JayDHulster/ithappens/arduinoNano.png

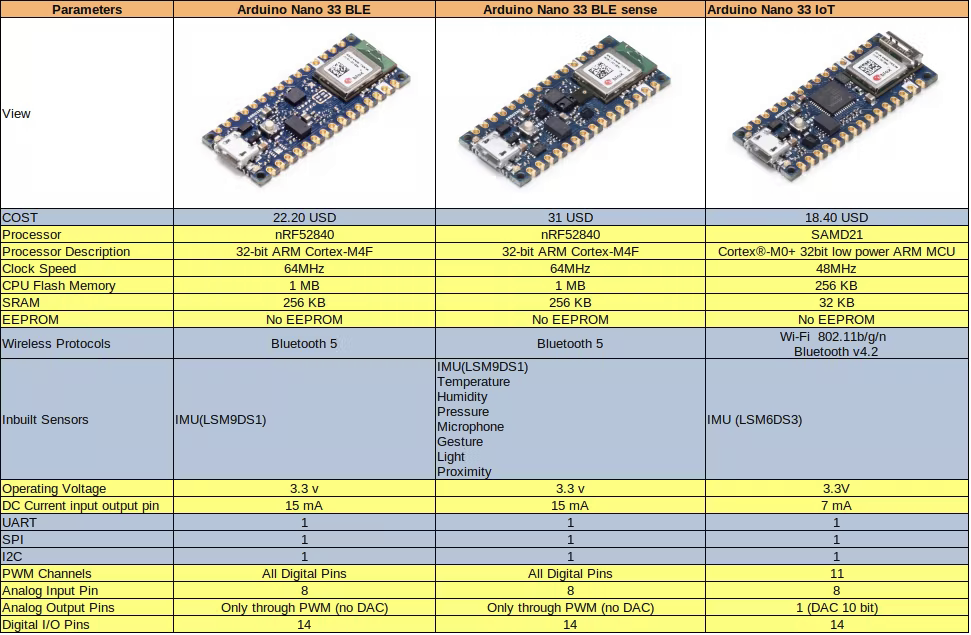
arduinoNano.png
