JayDHulster/ithappens/README.md

it happens

Te bekijken:

* https://github.com/smart-sensor-devices-ab/get_realtime_data_bleuio
* https://chipwired.com/collect-data-with-raspberry-pi/
