JayDHulster/ithappens/pcb/documentatie-biosensor.pdf

Bio-sensor: prototype

Datasheet 1/4inch druksensor

Dit is hoe het prototype
van de sensor werd
meegegeven

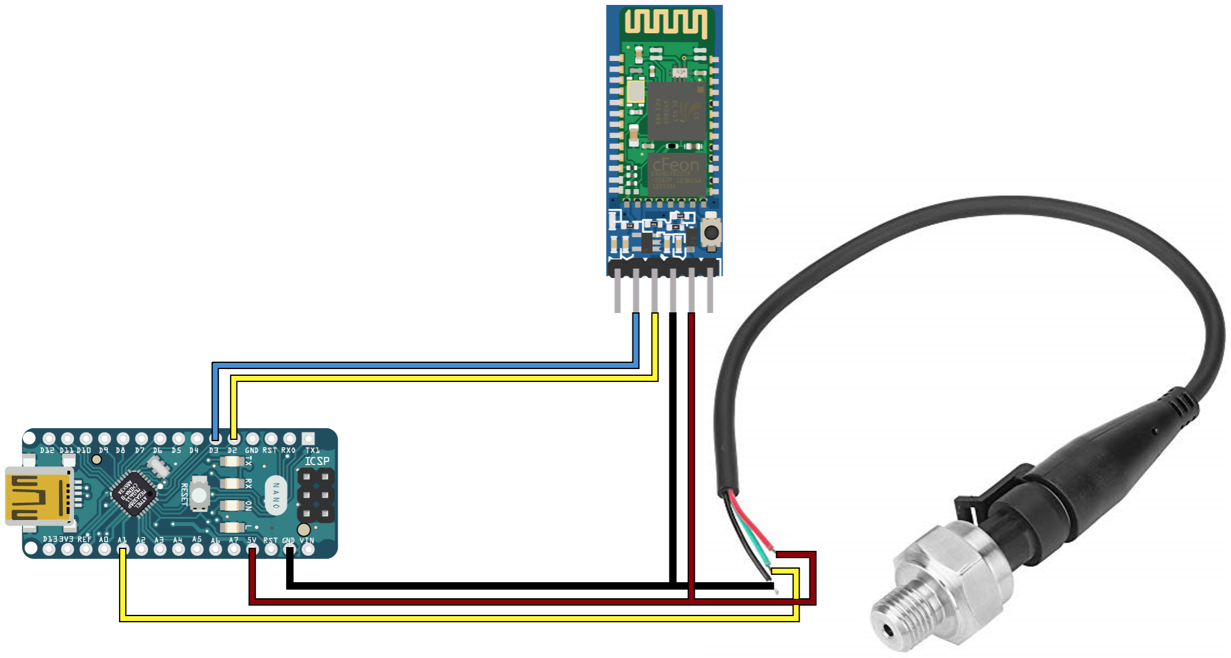
[picture p2: figure]

Verbeteringen:
Sensor testen en als de lezingen niet goed genoeg zijn een andere zoeken.

Als de sensor goed is, ontwerpen we de PCB om het systeem zo compact mogelijk te maken. Dit kunnen we doen met het KiCad programma of Eagle.
We kunnen inmiddels ook kijken voor een behuizing, zodat de elektronica beschermd wordt.

Componenten:
Arduino Nano BLE, Druksensor, Terminal Block Connector voor sensor, Batterijhouder, Batterij

Programmatie met de sensor

Betere code met calibratie:

De eerste verandering dat we kunnen doen is om de HC-05 bluetooth module eraf te smijten, inmiddels bestaat er nu een Arduino Nano 33 BLE (Bluetooth Low Energy) of de Nano 33 IoT microcontrollers met bluetooth ingebouwd.

Vervolgens kunnen we een pinout voorzien om de sensor op een gemakkelijke plaats aan te sluiten.

We zullen ook een batterij moeten voorzien om het systeem volledig draadloos te maken.

Als we op het bord zelf AI willen gebruiken (we moeten enkel maar data via bluetooth doorsturen), dan kunnen we de Arduino Nano 33 BLE Sense gebruiken met Embedded Artificial Intelligence; dit kost wel 35€


Bij gebruik van AI | [nice-to-have, niet noodzakelijk]:

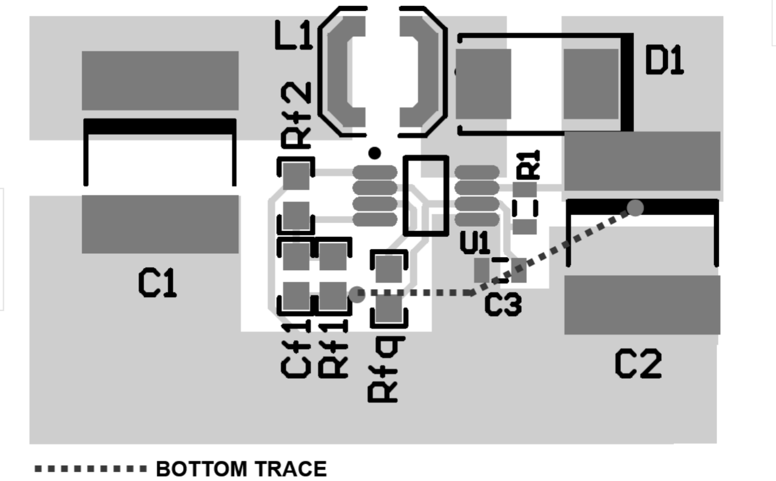
[picture p3: figure]

In deze discussie wordt uitgelegd hoe je het bordje zo lang mogelijk laat draaien op een batterij.
We kunnen ook de onboard regulator overslaan en rechtstreeks 3V3 aansluiten op de Nano, dit omdat de regulator ook energie verbruikt.

Dit artikel vermeldt ook dat deze configuratie wordt aangeraden in projecten waarbij de board voor lange tijden inactief is. Dit bord zal regelmatig data verzenden.

https://www.hackster.io/electronicsworkshop1 to-make-lipo-battery-charger-circuit-38f22f (https://www.hackster.io/electronicsworkshop111/how-to-make-lipo-battery-charger-circuit-38f22f)

www.hackster.io

https://www.instructables.com/Small-Format-Arduino-Nano-With-USB-Charging… (https://www.instructables.com/Small-Format-Arduino-Nano-With-USB-Charging-Circui/)

www.instructables.com

https://github.com/alltheworld/tp4056

github.com

https://bikepixels.com/2019/11/10/how-toadd-a-lipo-battery-in-our-arduino-projects/ (https://bikepixels.com/2019/11/10/how-to-add-a-lipo-battery-in-our-arduino-projects/)

bikepixels.com

We willen gebruikmaken van een lithium-ion of polymer batterij om het heroplaadbaar te maken.

Batterijbescherming:

Boost converter:

Behuizing: WH170-33-N

https://www.ti.com/lit/ds/symlink/lm2621.pdfts=1677760204285&ref_url=https%253A%252 (https://www.ti.com/lit/ds/symlink/lm2621.pdf?ts=1677760204285)

www.ti.com

https://www.takachi-enclosure.com/products/WH (https://www.takachi-enclosure.com/products/WH)

www.takachi-enclosure.com

https://forum.arduino.cc/t/nano-33-bleexternal-power-supply/919311/3 (https://forum.arduino.cc/t/nano-33-ble-external-power-supply/919311/3)

forum.arduino.cc

https://www.analyticsvidhya.com/blog/2022/0python-libraries-for-time-series-analysis/ (https://www.analyticsvidhya.com/blog/2022/05/5-python-libraries-for-time-series-analysis/)

www.analyticsvidhya.com

https://media.digikey.com/pdf/Data%20Sheet

media.digikey.com

https://www.youtube.com/watch?v=UrqPxwsPWGk (https://www.youtube.com/watch?v=UrqPxwsPWGk)

www.youtube.com

https://forum.arduino.cc/t/pressuretransducer-code/362754/36 (https://forum.arduino.cc/t/pressure-transducer-code/362754/36)

forum.arduino.cc

https://support.arduino.cc/hc/enus/articles/360014735580-Nano-boards-… (https://support.arduino.cc/hc/en-us/articles/360014735580-Nano-boards-that-can-be-powered-directly-with-3-3-V)

support.arduino.cc

https://github.com/arduinolibraries/ArduinoBLE/pull/15#issuecomme… (https://github.com/arduino-libraries/ArduinoBLE/pull/15#issuecomment-530084737)

github.com

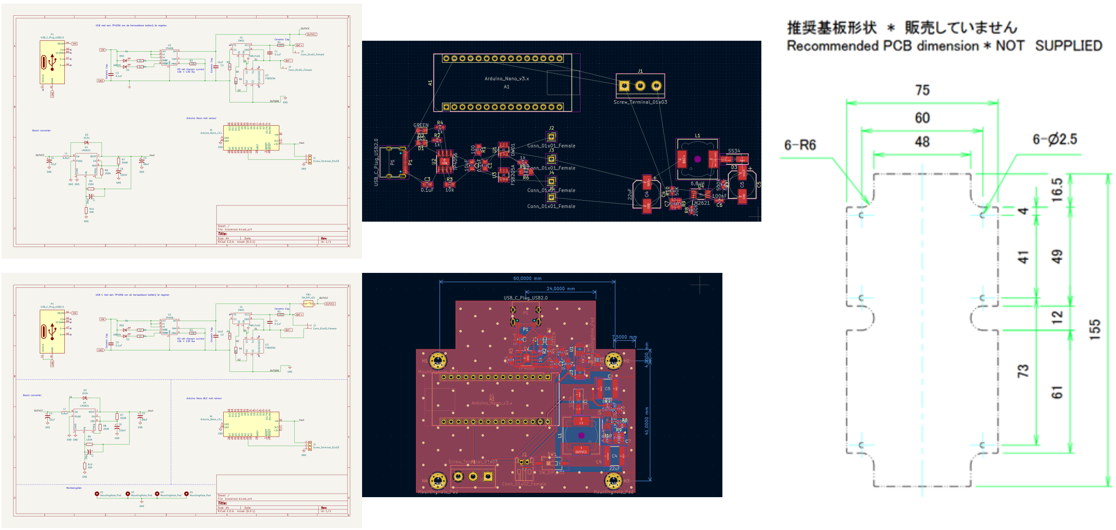
[picture p4: figure]
