JayDHulster/ithappens/app-design/concept.png

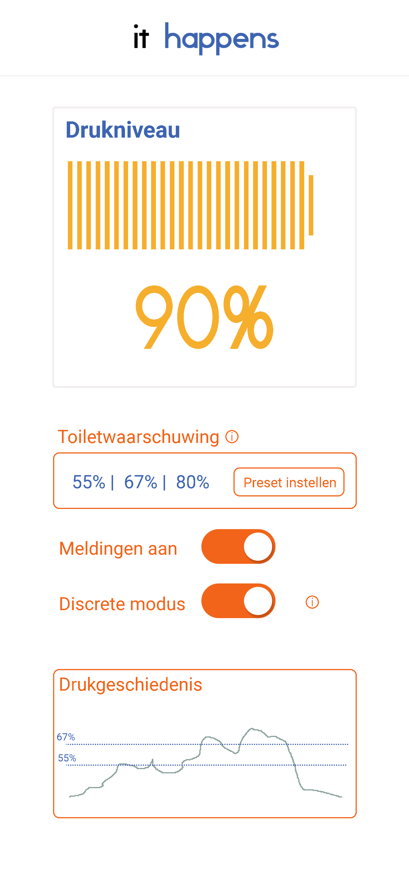
app-design/concept.png
