JayDHulster/ithappens/app-design/conceptv2.png

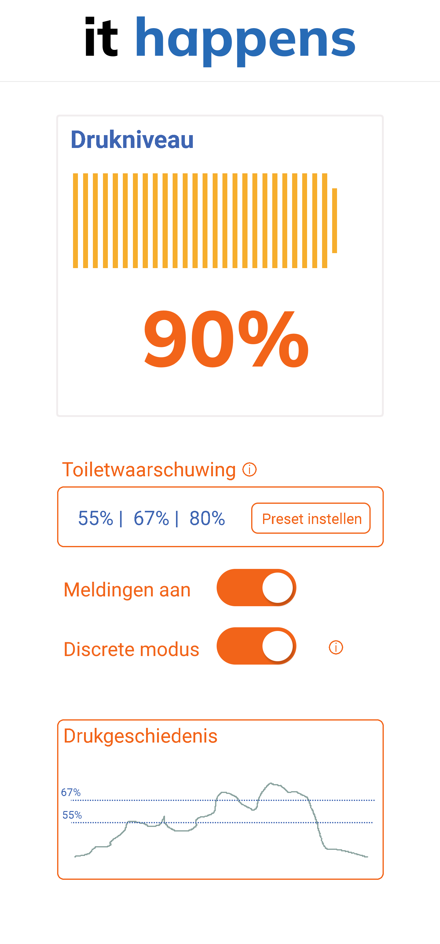
app-design/conceptv2.png
