JayDHulster/ithappens/app-design/drukpercentage.png

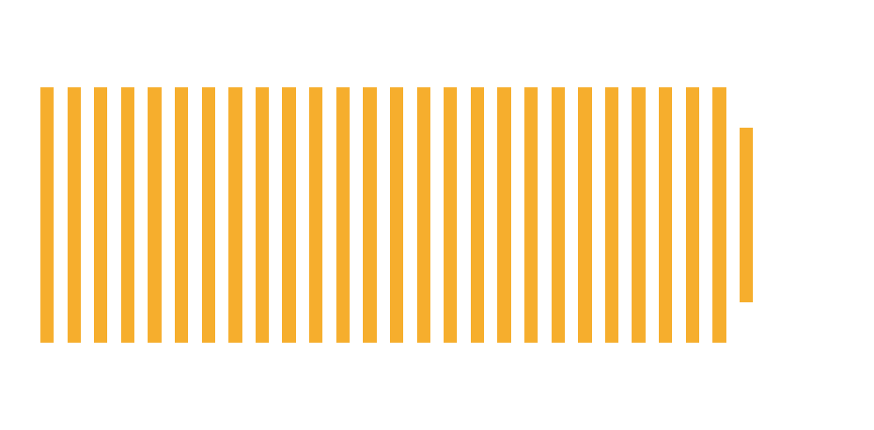
app-design/drukpercentage.png
