JayDHulster/ithappens/app-design/kleurenpalet.png

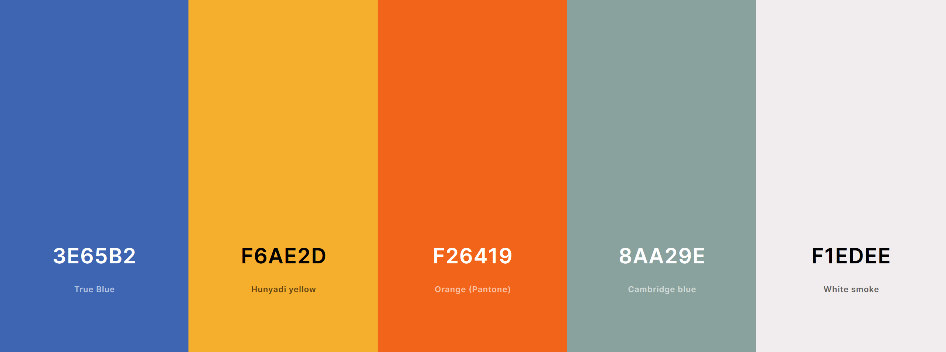
app-design/kleurenpalet.png
