JayDHulster/ithappens/schematics/first-prototype.png

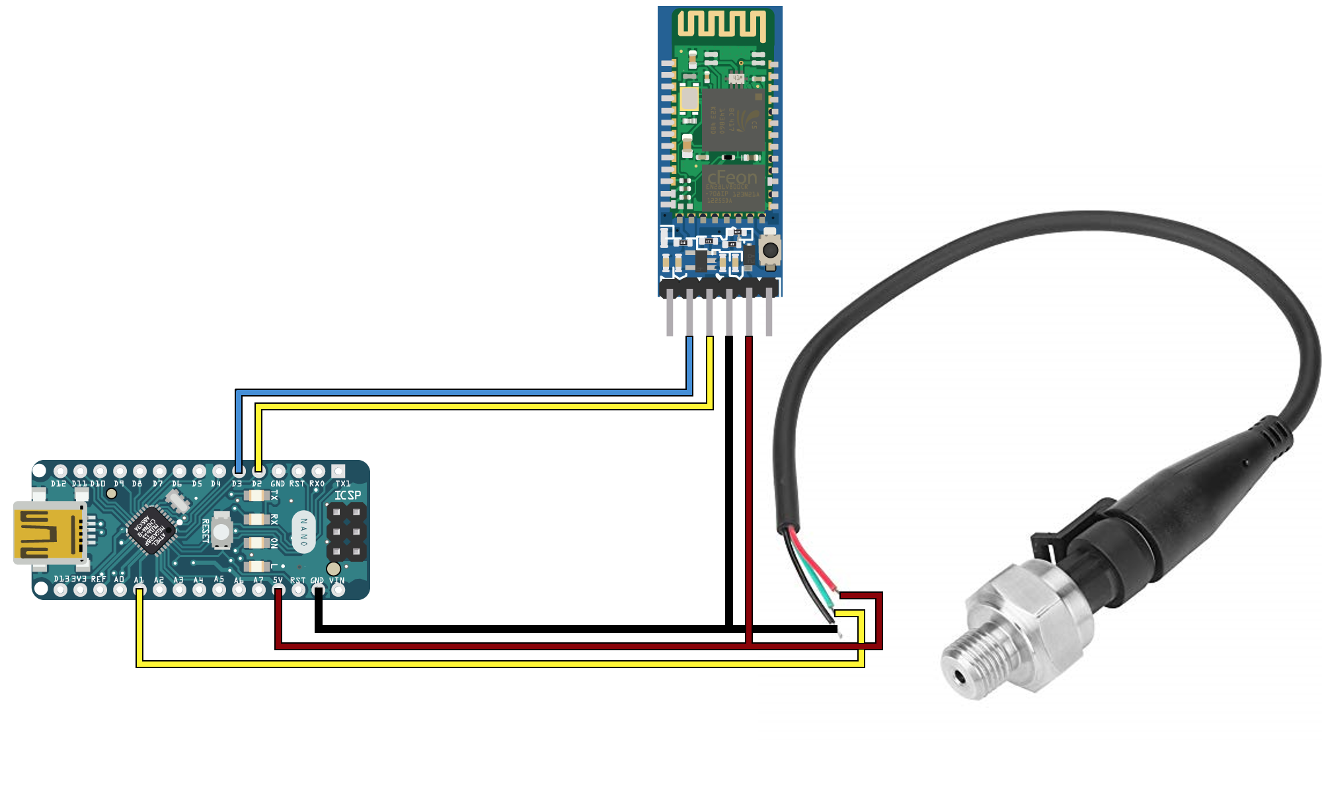
schematics/first-prototype.png
