JayDHulster/ithappens/pcb/595D/LPS4018-223MRC.stp

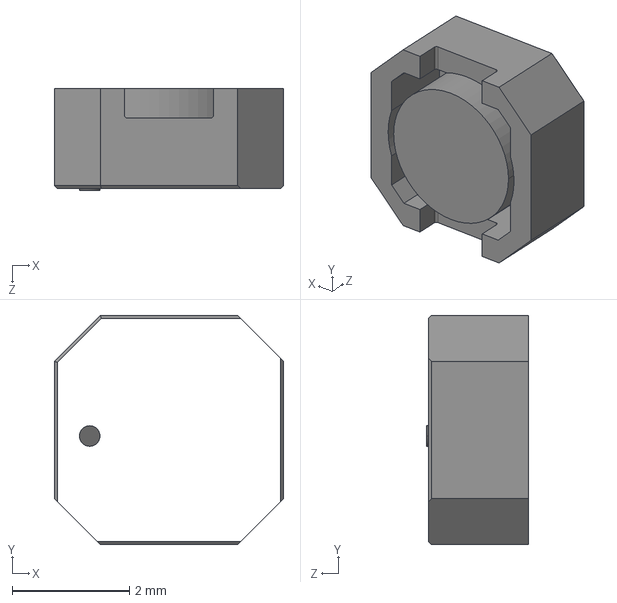
[picture p10: CAD file, 2023-06-10]
pcb/595D/LPS4018-223MRC.stp
3.90 x 3.90 x 1.73 mm
