JayDHulster/ithappens/pcb/biosensor/biosensor.kicad_pcb

## KiCad design pcb/biosensor/biosensor.kicad_pcb (2023-06-10)

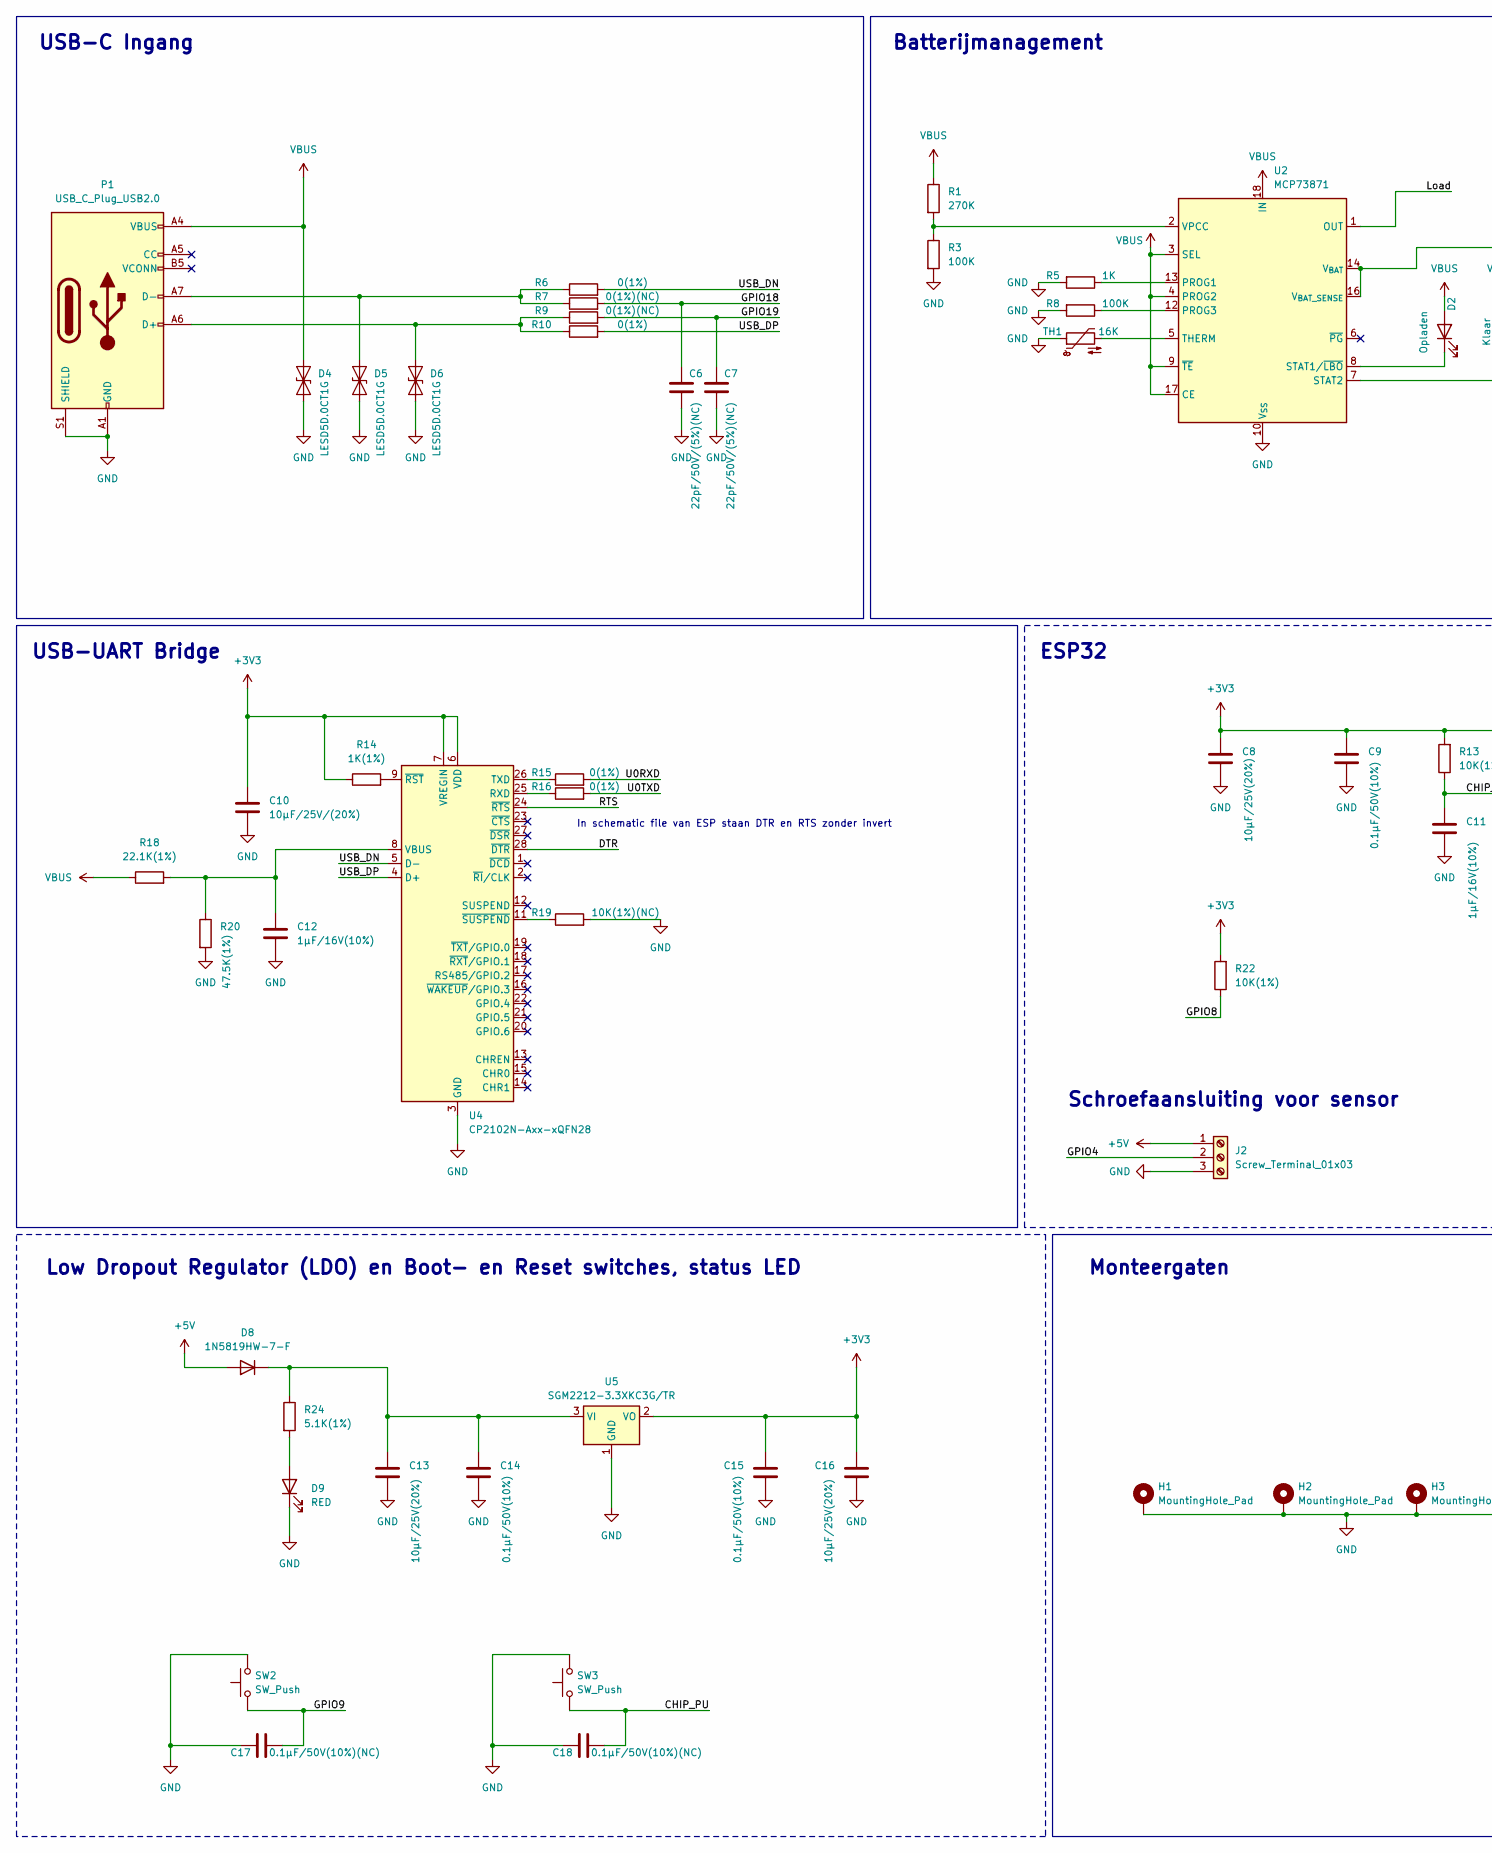
[picture p11: schematic biosensor.kicad_sch, part in row 1, column 1]

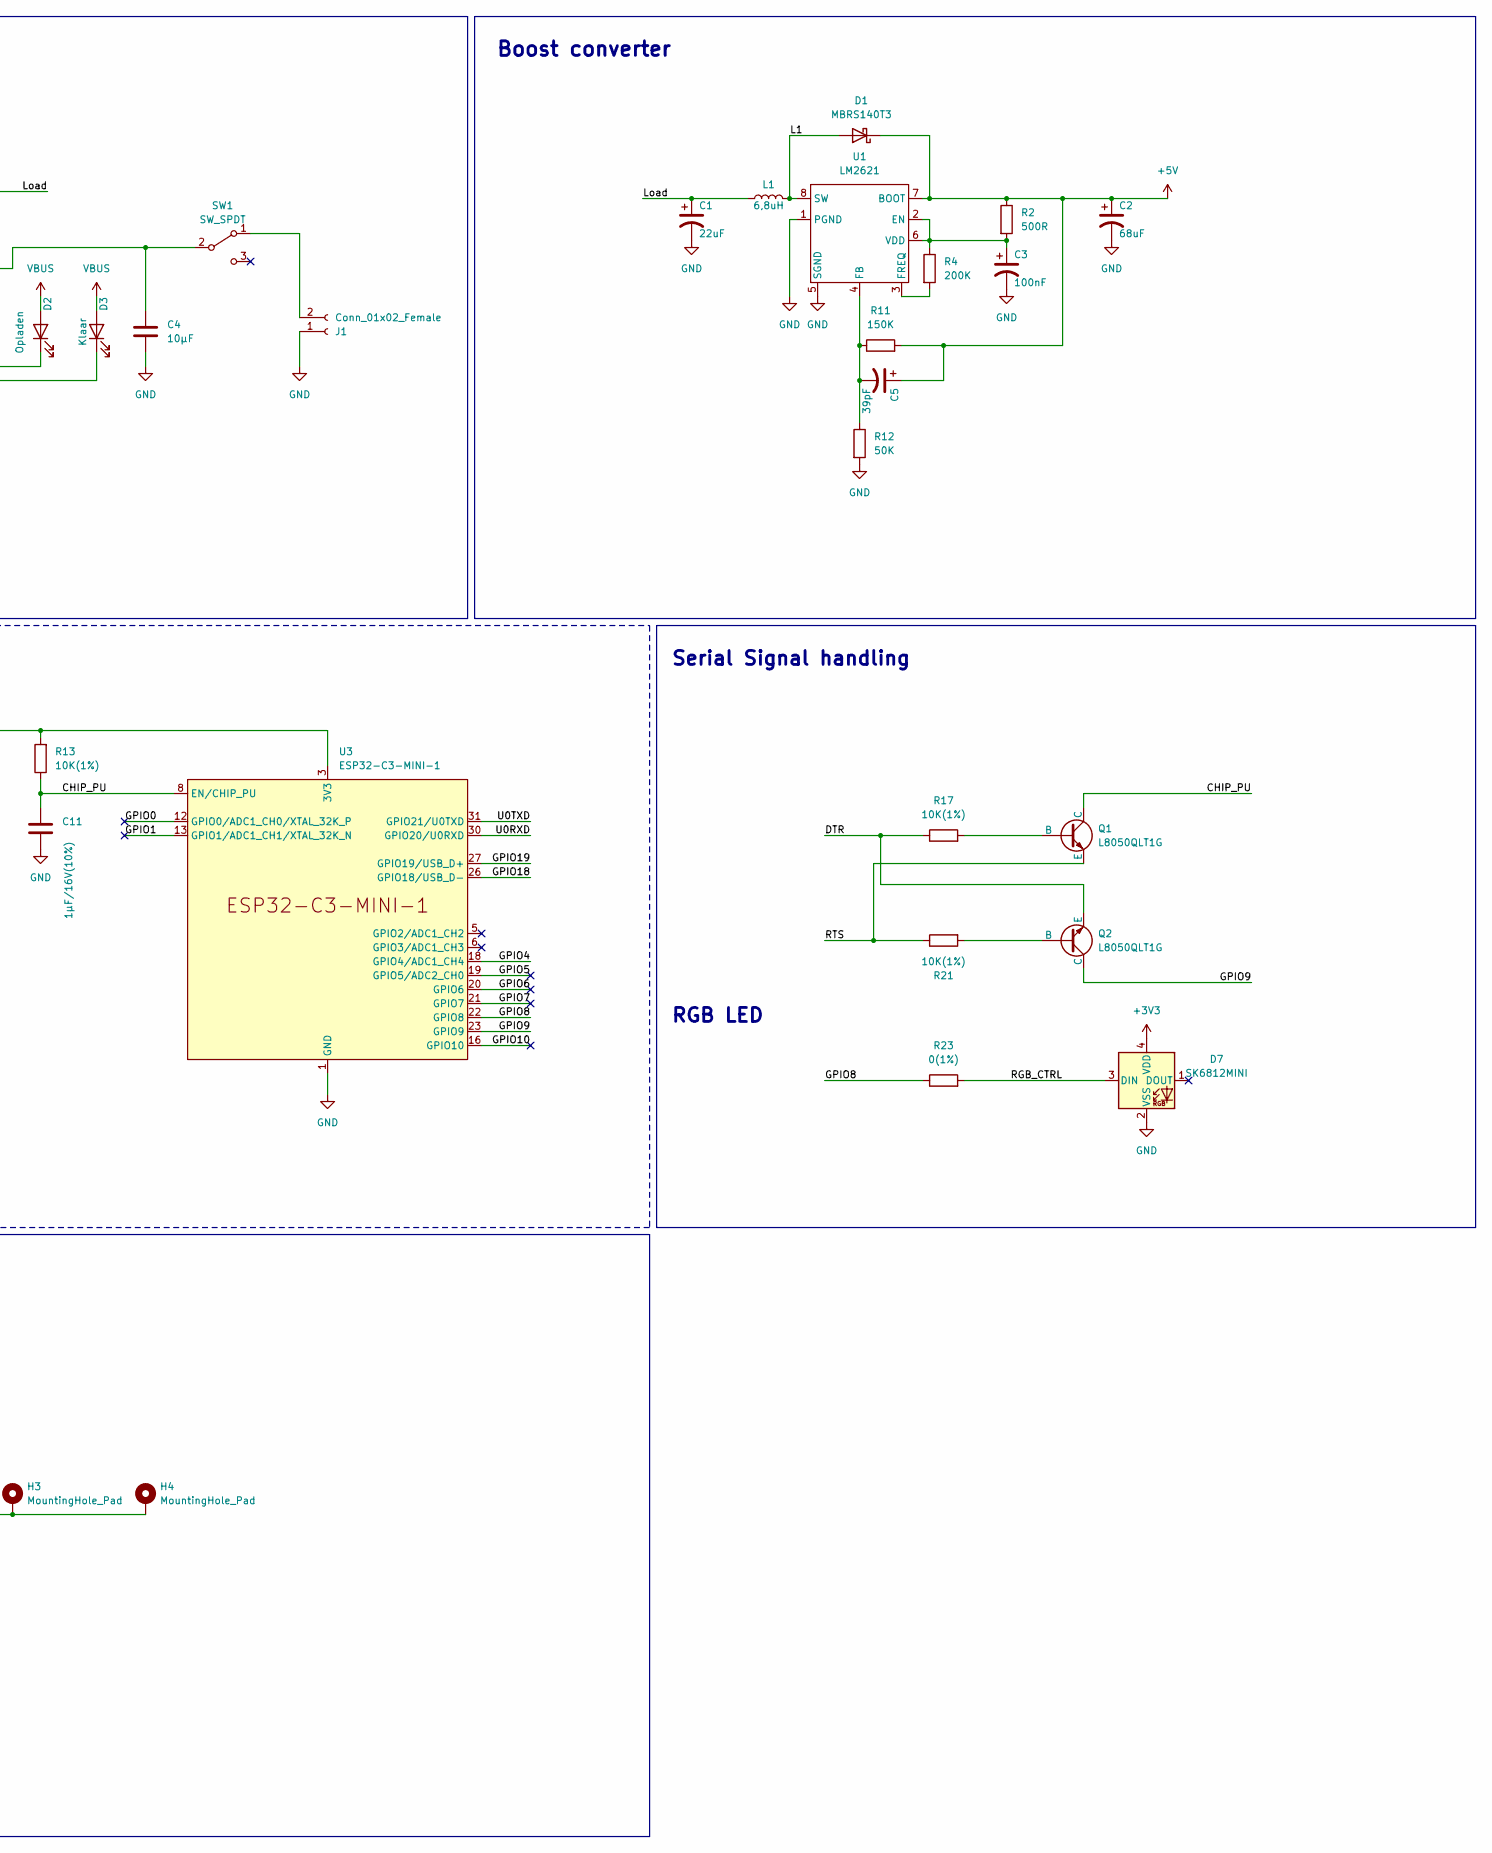
[picture p12: schematic biosensor.kicad_sch, part in row 1, column 2]

Parts:
C1: 22uF; CAP_595D-B_VSS
C2: 68uF; CAP_595D-C_VSS
C3: 100nF; C_0603_1608Metric_Pad1.08x0.95mm_HandSolder
C4: 10µF; C_0603_1608Metric_Pad1.08x0.95mm_HandSolder
C5: 39pF; C_0603_1608Metric_Pad1.08x0.95mm_HandSolder
C6, C7: 22pF/50V/(5%)(NC); C_0603_1608Metric_Pad1.08x0.95mm_HandSolder
C8, C13, C16: 10µF/25V(20%); C_0603_1608Metric_Pad1.08x0.95mm_HandSolder
C9, C14, C15: 0.1µF/50V(10%); C_0603_1608Metric_Pad1.08x0.95mm_HandSolder
C10: 10µF/25V/(20%); C_0603_1608Metric_Pad1.08x0.95mm_HandSolder
C11, C12: 1µF/16V(10%); C_0603_1608Metric_Pad1.08x0.95mm_HandSolder
C17, C18: 0.1µF/50V(10%)(NC); C_0603_1608Metric_Pad1.08x0.95mm_HandSolder
D1: MBRS140T3; D_SMB_Handsoldering
D2: Opladen; LED_0805_2012Metric_Pad1.15x1.40mm_HandSolder
D3: Klaar; LED_0805_2012Metric_Pad1.15x1.40mm_HandSolder
D4, D5, D6: LESD5D.0CT1G; D_SOD-523
D7: SK6812MINI; LED_SK6812MINI_PLCC4_3.5x3.5mm_P1.75mm
D8: 1N5819HW-7-F; D_SOD-123
D9: RED; LED_0805_2012Metric_Pad1.15x1.40mm_HandSolder
H1, H2, H3, H4: MountingHole_Pad; MountingHole_2.7mm_Pad_Via
J1: Conn_01x02_Female; JST_PH_S2B-PH-K_1x02_P2.00mm_Horizontal
J2: Screw_Terminal_01x03; TerminalBlock_bornier-3_P5.08mm
L1: 6,8uH; LPS4018223MRC
P1: USB_C_Plug_USB2.0; USB_C_Receptacle_HRO_TYPE-C-31-M-12
Q1, Q2: L8050QLT1G; SOT-23
R1: 270K; R_0603_1608Metric_Pad0.98x0.95mm_HandSolder
R2: 500R; R_0603_1608Metric
R3, R8: 100K; R_0603_1608Metric_Pad0.98x0.95mm_HandSolder
R4: 200K; R_0603_1608Metric
R5: 1K; R_0603_1608Metric_Pad0.98x0.95mm_HandSolder
R6, R10, R15, R16, R23: 0(1%); R_0603_1608Metric_Pad0.98x0.95mm_HandSolder
R7, R9: 0(1%)(NC); R_0603_1608Metric_Pad0.98x0.95mm_HandSolder
R11: 150K; R_0603_1608Metric_Pad0.98x0.95mm_HandSolder
R12: 50K; R_0603_1608Metric_Pad0.98x0.95mm_HandSolder
R13, R17, R21, R22: 10K(1%); R_0603_1608Metric_Pad0.98x0.95mm_HandSolder
R14: 1K(1%); R_0603_1608Metric_Pad0.98x0.95mm_HandSolder
R18: 22.1K(1%); R_0603_1608Metric_Pad0.98x0.95mm_HandSolder
R19: 10K(1%)(NC); R_0603_1608Metric_Pad0.98x0.95mm_HandSolder
R20: 47.5K(1%); R_0603_1608Metric_Pad0.98x0.95mm_HandSolder
R24: 5.1K(1%); R_0603_1608Metric_Pad0.98x0.95mm_HandSolder
SW1: SW_SPDT; SW_Slide_1P2T_CK_OS102011MS2Q
SW2, SW3: SW_Push; SW_PUSH_6mm
TH1: 16K; R_0603_1608Metric_Pad0.98x0.95mm_HandSolder
U1: LM2621; VSSOP-8_3.0x3.0mm_P0.65mm
U2: MCP73871; QFN-20-1EP_4x4mm_P0.5mm_EP2.5x2.5mm
U3: ESP32-C3-MINI-1
U4: CP2102N-Axx-xQFN28; QFN-28-1EP_5x5mm_P0.5mm_EP3.35x3.35mm
U5: SGM2212-3.3XKC3G/TR; SOT-223-3_TabPin2

Connections:
+3V3: C8.1, C9.1, C10.1, C15.1, C16.1, D7.4 (VDD), R13.2, R14.1, R22.2, U3.3 (3V3), U4.6 (VDD), U4.7 (VREGIN), U5.2 (VO)
+5V: C2.1, C5.1, D1.1 (K), D8.2 (A), J2.1, R2.1, R11.2, U1.7 (BOOT)
/CHIP_PU: C11.1, C18.2, Q1.1 (C), R13.1, SW3.1, U3.8 (EN/CHIP_PU)
/DTR: Q2.3 (E), R17.1, U4.28 (~DTR)
/GPIO0: U3.12 (GPIO0/ADC1_CH0/XTAL_32K_P)
/GPIO1: U3.13 (GPIO1/ADC1_CH1/XTAL_32K_N)
/GPIO4: J2.2, U3.18 (GPIO4/ADC1_CH4)
/GPIO5: U3.19 (GPIO5/ADC2_CH0)
/GPIO6: U3.20 (GPIO6)
/GPIO7: U3.21 (GPIO7)
/GPIO8: R22.1, R23.1, U3.22 (GPIO8)
/GPIO9: C17.2, Q2.1 (C), SW2.1, U3.23 (GPIO9)
/GPIO10: U3.16 (GPIO10)
/GPIO18: C6.1, R7.2, U3.26 (GPIO18/USB_D-)
/GPIO19: C7.1, R9.2, U3.27 (GPIO19/USB_D+)
/L1: D1.2 (A), L1.2, U1.8 (SW)
/Load: C1.1, L1.1, U2.1 (OUT), U2.20 (OUT)
/RGB_CTRL: D7.3 (DIN), R23.2
/RTS: Q1.3 (E), R21.1, U4.24 (~RTS)
/U0RXD: R15.2, U3.30 (GPIO20/U0RXD)
/U0TXD: R16.2, U3.31 (GPIO21/U0TXD)
/USB_DN: R6.2, U4.5 (D-)
/USB_DP: R10.2, U4.4 (D+)
GND: C1.2, C2.2, C3.2, C4.2, C6.2, C7.2, C8.2, C9.2, C10.2, C11.2, C12.2, C13.2, C14.2, C15.2, C16.2, C17.1, C18.1, D4.1 (A1), D5.1 (A1), D6.1 (A1), D7.2 (VSS), D9.1 (K), H1.1, H2.1, H3.1, H4.1, J1.1, J2.3, P1.A1 (GND), P1.A12 (GND), P1.B1 (GND), P1.B12 (GND), P1.S1 (SHIELD), R3.2, R5.2, R8.2, R12.2, R19.2, R20.2, SW2.2, SW3.2, TH1.1, U1.1 (PGND), U1.5 (SGND), U2.10 (V_{SS}), U2.11 (V_{SS}), U2.21 (V_{SS}), U3.1 (GND), U3.2 (GND), U3.11 (GND), U3.14 (GND), U3.36 (GND), U3.37 (GND), U3.38 (GND), U3.39 (GND), U3.40 (GND), U3.41 (GND), U3.42 (GND), U3.43 (GND), U3.44 (GND), U3.45 (GND), U3.46 (GND), U3.47 (GND), U3.48 (GND), U3.49 (GND), U3.50 (GND), U3.51 (GND), U3.52 (GND), U3.53 (GND), U4.3 (GND), U4.29 (GND), U5.1 (GND)
unnamed: D2.1 (K), U2.8 (STAT1/~LBO)
unnamed: D3.1 (K), U2.7 (STAT2)
unnamed: D5.2 (A2), P1.A7 (D-), R6.1, R7.1
unnamed: D6.2 (A2), P1.A6 (D+), R9.1, R10.1
unnamed: C13.1, C14.1, D8.1 (K), R24.1, U5.3 (VI)
unnamed: D9.2 (A), R24.2
unnamed: J1.2, SW1.1 (A)
unnamed: Q1.2 (B), R17.2
unnamed: Q2.2 (B), R21.2
unnamed: C4.1, SW1.2 (B), U2.14 (V_{BAT}), U2.15 (V_{BAT}), U2.16 (V_{BAT_SENSE})
unnamed: C3.1, R2.2, R4.1, U1.2 (EN), U1.6 (VDD)
unnamed: C5.2, R11.1, R12.1, U1.4 (FB)
unnamed: R4.2, U1.3 (FREQ)
unnamed: R5.1, U2.13 (PROG1)
unnamed: R8.1, U2.12 (PROG3)
unnamed: TH1.2, U2.5 (THERM)
unnamed: R1.2, R3.1, U2.2 (VPCC)
unnamed: R16.1, U4.25 (RXD)
unnamed: R15.1, U4.26 (TXD)
unnamed: C12.1, R18.2, R20.1, U4.8 (VBUS)
unnamed: R14.2, U4.9 (~RST)
unnamed: R19.1, U4.11 (~SUSPEND)
VBUS: D2.2 (A), D3.2 (A), D4.2 (A2), P1.A4 (VBUS), P1.A9 (VBUS), P1.B4 (VBUS), P1.B9 (VBUS), R1.1, R18.1, U2.3 (SEL), U2.4 (PROG2), U2.9 (~TE), U2.17 (CE), U2.18 (IN), U2.19 (IN)

Notes on the sheet:
Low Dropout Regulator (LDO) en Boot- en Reset switches, status LED
RGB LED
USB-C Ingang
In schematic file van ESP staan DTR en RTS zonder invert
Boost converter
Monteergaten
USB-UART Bridge
Batterijmanagement
Serial Signal handling
Schroefaansluiting voor sensor
ESP32

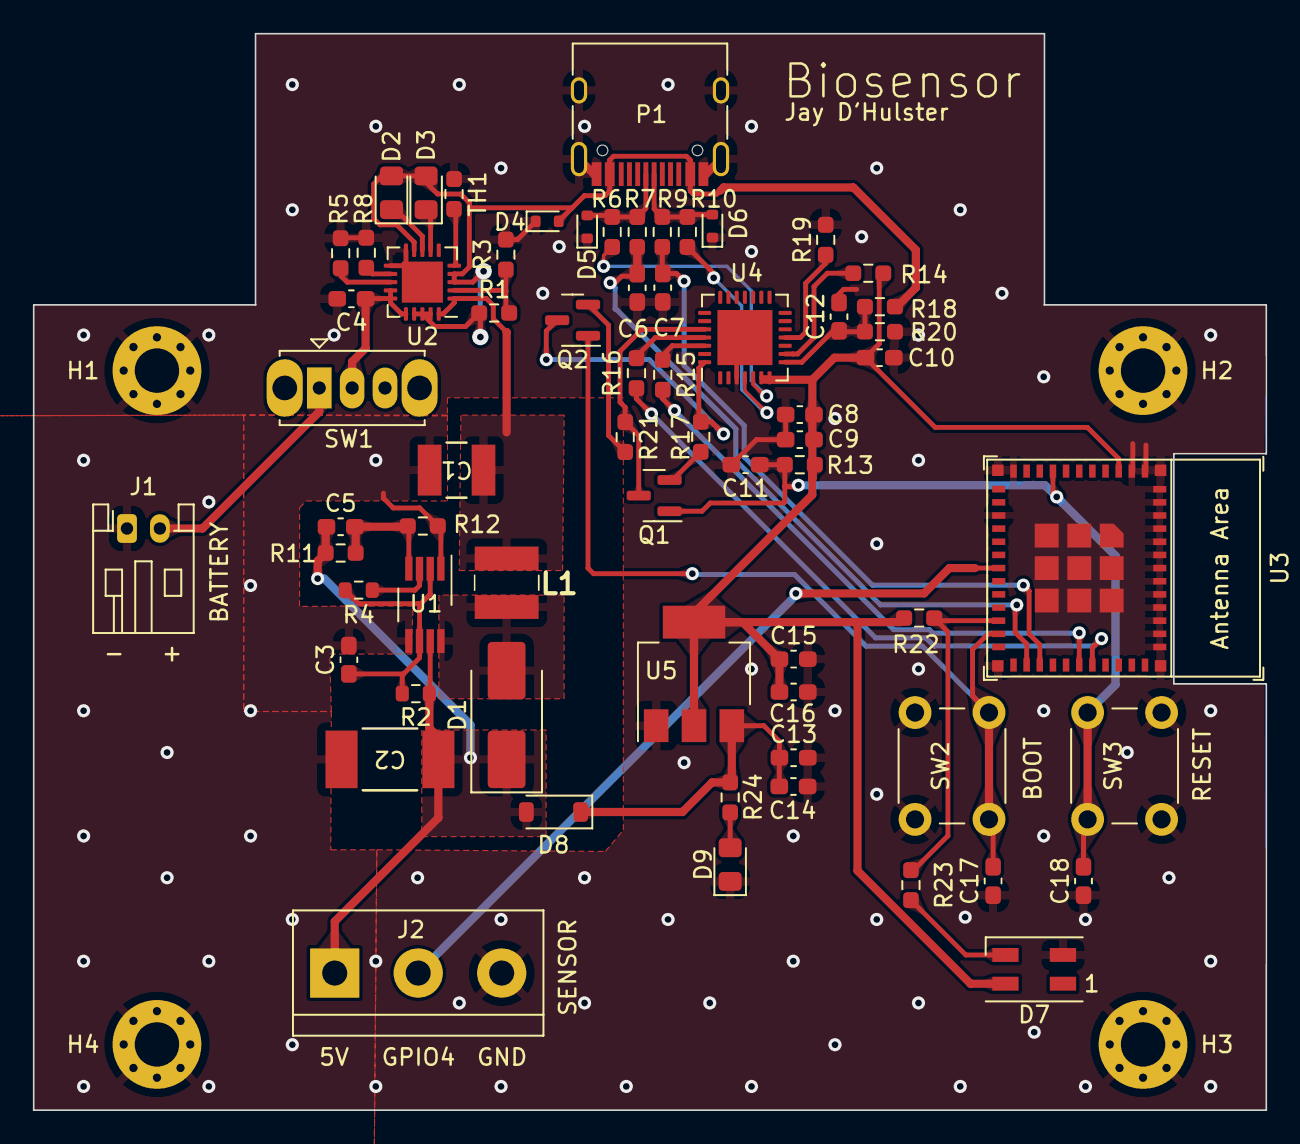
[picture p13: board pcb/biosensor/biosensor.kicad_pcb from above]

Board: 2 copper layers, 75.0 x 65.5 mm, 70 parts (0 on the bottom side), 41 nets.
