JayDHulster/ithappens/pcb/biosensor - v1/biosensor.kicad_pcb

## KiCad design pcb/biosensor - v1/biosensor.kicad_pcb (2023-03-20, an earlier design)

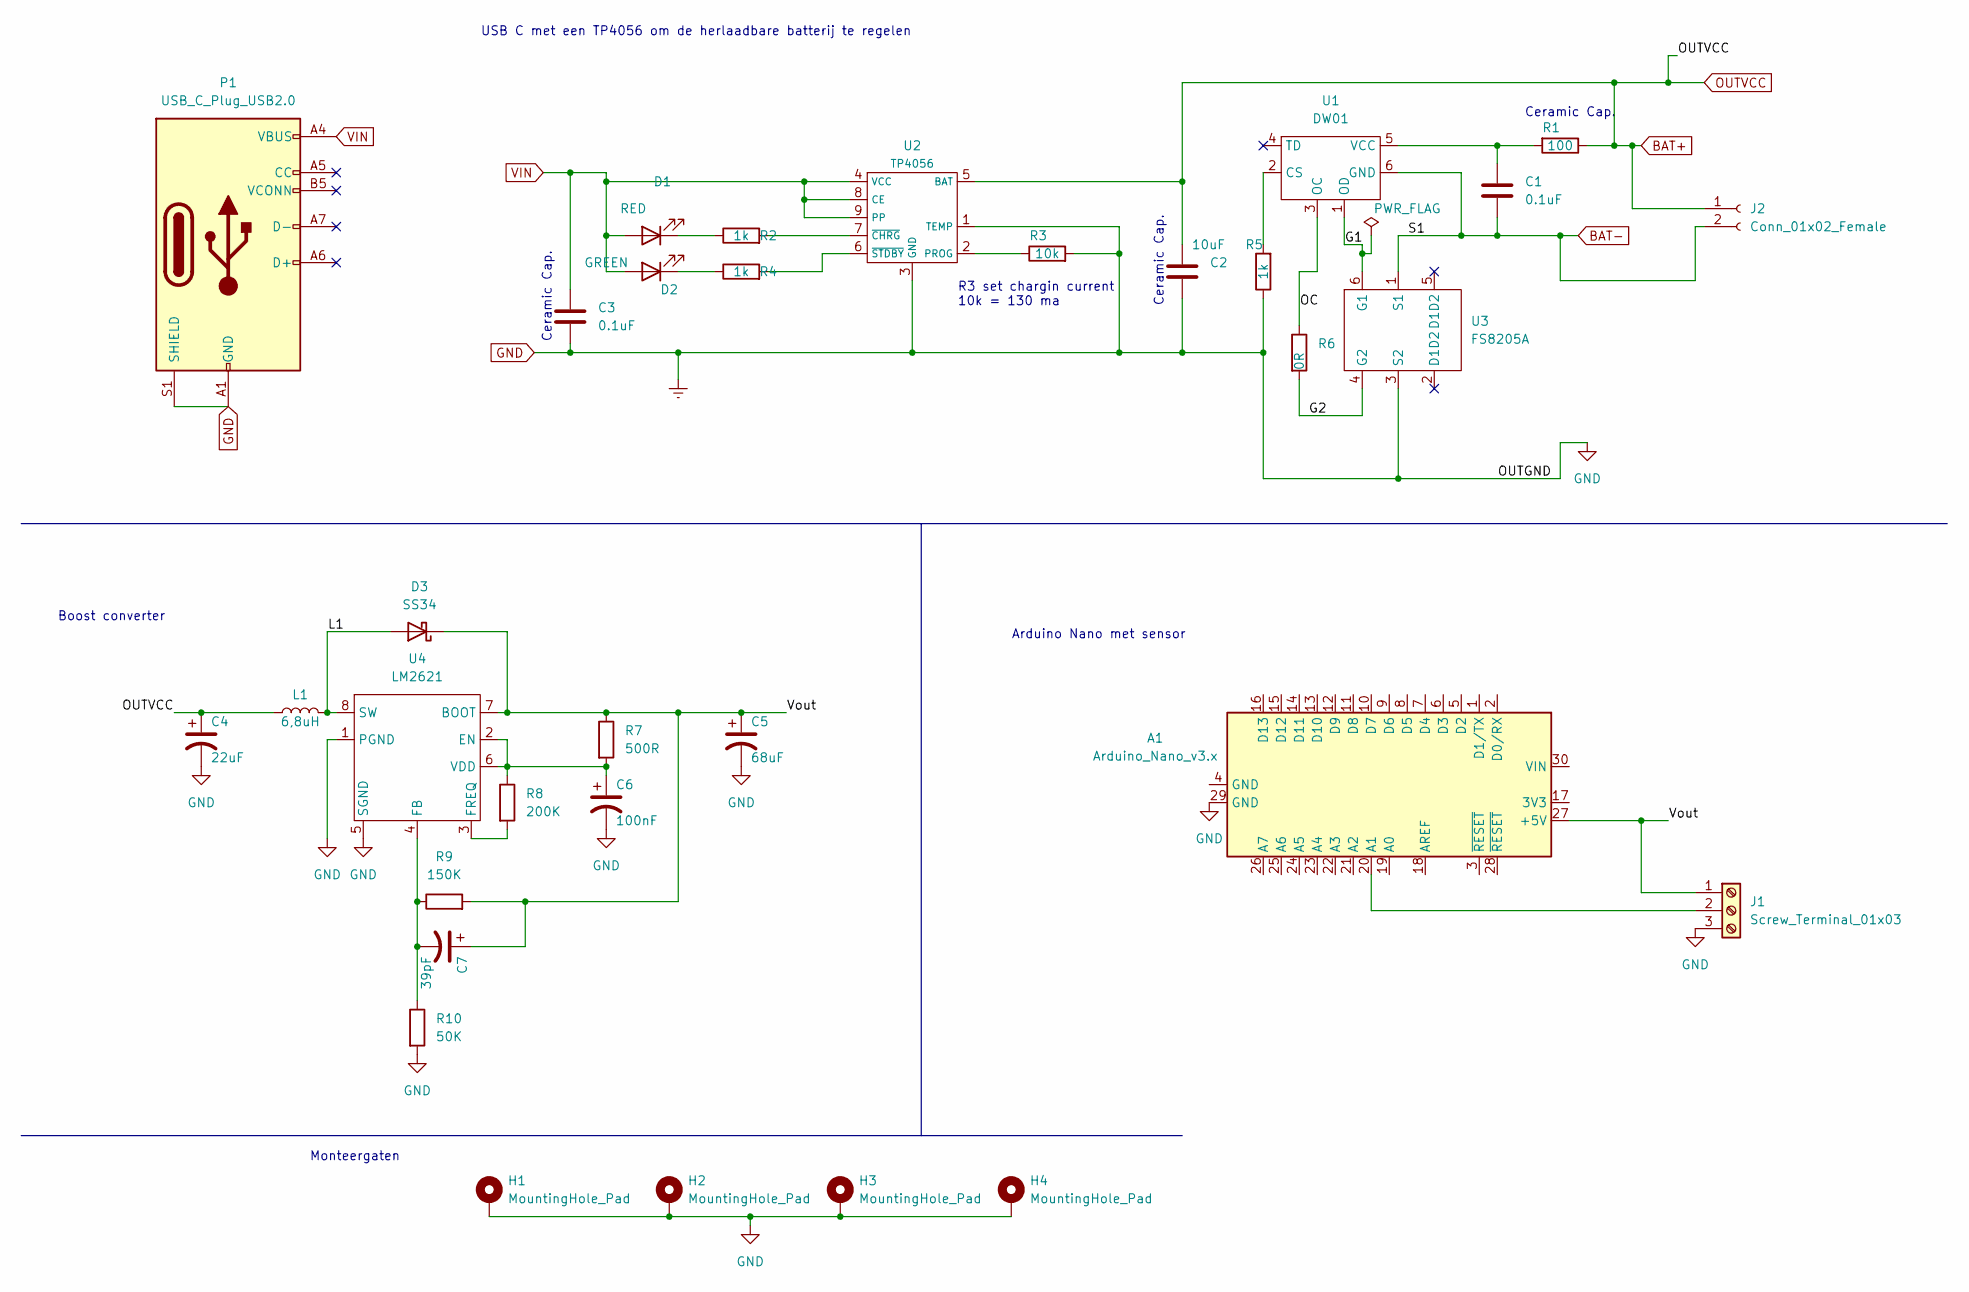
[picture p14: schematic biosensor.kicad_sch]

Parts:
A1: Arduino_Nano_v3.x; Arduino_Nano
C1, C3: 0.1uF; C_0805_2012Metric_Pad1.18x1.45mm_HandSolder
C2: 10uF; C_0805_2012Metric_Pad1.18x1.45mm_HandSolder
C4: 22uF; C_2225_5664Metric_Pad1.80x6.60mm_HandSolder
C5: 68uF; C_2225_5664Metric_Pad1.80x6.60mm_HandSolder
C6: 100nF; C_0603_1608Metric_Pad1.08x0.95mm_HandSolder
C7: 39pF; C_0805_2012Metric_Pad1.18x1.45mm_HandSolder
D1: RED; LED_0805_2012Metric_Pad1.15x1.40mm_HandSolder
D2: GREEN; LED_0805_2012Metric_Pad1.15x1.40mm_HandSolder
D3: SS34; D_SMA_Handsoldering
H1, H2, H3, H4: MountingHole_Pad; MountingHole_2.7mm_Pad_Via
J1: Screw_Terminal_01x03; TerminalBlock_bornier-3_P5.08mm
J2: Conn_01x02_Female; Molex_PicoBlade_53048-0210_1x02_P1.25mm_Horizontal
L1: 6,8uH; L_12x12mm_H8mm
P1: USB_C_Plug_USB2.0; USB_C_Receptacle_HRO_TYPE-C-31-M-12
R1: 100; R_0805_2012Metric_Pad1.20x1.40mm_HandSolder
R2, R4, R5: 1k; R_0603_1608Metric_Pad0.98x0.95mm_HandSolder
R3: 10k; R_0805_2012Metric_Pad1.20x1.40mm_HandSolder
R6: 0R; R_1206_3216Metric_Pad1.30x1.75mm_HandSolder
R7: 500R; R_0603_1608Metric
R8: 200K; R_0603_1608Metric
R9: 150K; R_0805_2012Metric_Pad1.20x1.40mm_HandSolder
R10: 50K; R_0603_1608Metric
U1: DW01; SOT-23-6_Handsoldering
U2: TP4056; SOIC-8-1EP_3.9x4.9mm_P1.27mm_EP2.29x3mm
U3: FS8205A; SOT-23-6_Handsoldering
U4: LM2621; VSSOP-8_3.0x3.0mm_P0.65mm

Connections:
/G1: U1.1 (OD), U3.6 (G1)
/G2: R6.2, U3.4 (G2)
/L1: D3.2 (A), L1.2, U4.8 (SW)
/OC: R6.1, U1.3 (OC)
/Vout: A1.27 (+5V), C5.1, C7.1, D3.1 (K), J1.1, R7.1, R9.2, U4.7 (BOOT)
BAT+: C2.1, C4.1, J2.1, L1.1, R1.1, U2.5 (BAT)
BAT-: C1.2, J2.2, U1.6 (GND), U3.1 (S1)
GND: A1.29 (GND), C2.2, C3.2, C4.2, C5.2, C6.2, H1.1, H2.1, H3.1, H4.1, J1.3, P1.A1 (GND), P1.A12 (GND), P1.B1 (GND), P1.B12 (GND), P1.S1 (SHIELD), R3.2, R5.1, R10.2, U2.1 (TEMP), U2.3 (GND), U3.3 (S2), U4.1 (PGND), U4.5 (SGND)
unnamed: A1.20 (A1), J1.2
unnamed: C1.1, R1.2, U1.5 (VCC)
unnamed: C6.1, R7.2, R8.1, U4.2 (EN), U4.6 (VDD)
unnamed: C7.2, R9.1, R10.1, U4.4 (FB)
unnamed: D1.1 (K), R2.1
unnamed: D2.1 (K), R4.1
unnamed: R2.2, U2.7 (~CHRG)
unnamed: R3.1, U2.2 (PROG)
unnamed: R4.2, U2.6 (~STDBY)
unnamed: R5.2, U1.2 (CS)
unnamed: R8.2, U4.3 (FREQ)
VIN: C3.1, D1.2 (A), D2.2 (A), P1.A4 (VBUS), P1.A9 (VBUS), P1.B4 (VBUS), P1.B9 (VBUS), U2.4 (VCC), U2.8 (CE), U2.9 (PP)

Notes on the sheet:
R3 set chargin current 10k = 130 ma
Boost converter
Arduino Nano met sensor
Ceramic Cap.
Monteergaten
USB C met een TP4056 om de herlaadbare batterij te regelen

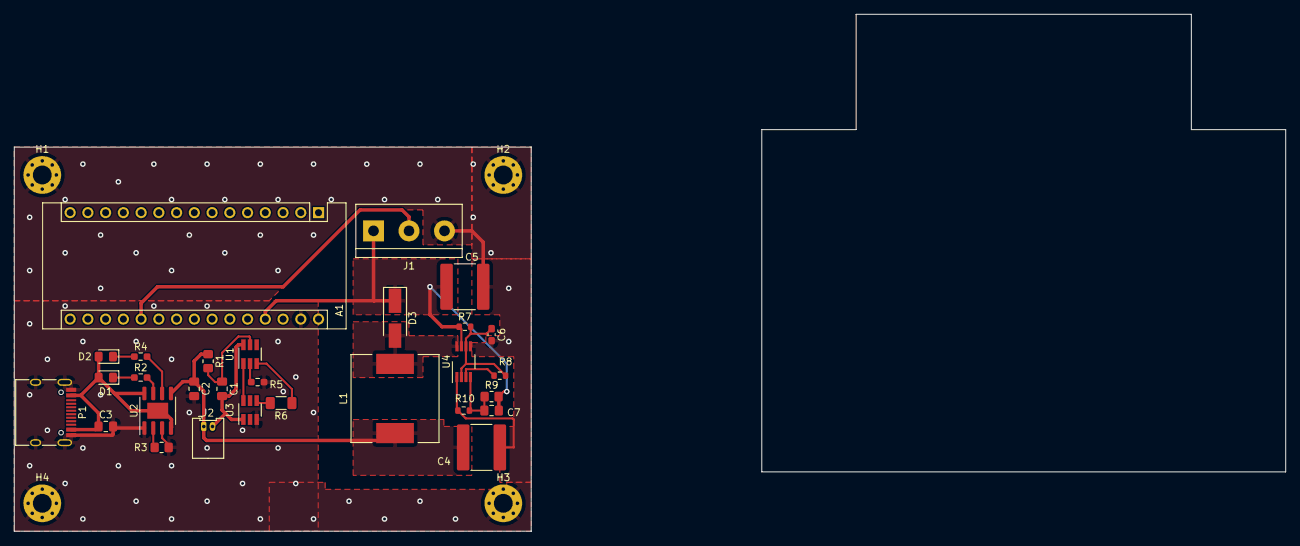
[picture p15: board pcb/biosensor - v1/biosensor.kicad_pcb from above]

Board: 2 copper layers, 74.0 x 55.0 mm, 33 parts (0 on the bottom side), 20 nets.
