JayDHulster/ithappens/Arduino/Biosensor/Biosensor.ino

const int pressureInput = A1; //select the analog input pin for the pressure transducer
const int pressureZero = 102.4; //analog reading of pressure transducer at 0psi
const int pressureMax = 921.6; //analog reading of pressure transducer at 100psi
const int pressuretransducermaxPSI = 100; //psi value of transducer being used
const int baudRate = 9600; //constant integer to set the baud rate for serial monitor
const int sensorreadDelay = 1000; //constant integer to set the sensor read delay in milliseconds

float pressureValue = 0; //variable to store the value coming from the pressure transducer


void setup() //setup routine, runs once when system turned on or reset
{
  Serial.begin(baudRate); //initializes serial communication at set baud rate bits per second
  // pinMode(A1, INPUT_PULLUP);
}

void loop() //loop routine runs over and over again forever
{
  // pressureValue = analogRead(pressureInput); //reads value from input pin and assigns to variable
  // pressureValue = ((pressureValue-pressureZero)*pressuretransducermaxPSI)/(pressureMax-pressureZero); //conversion equation to convert analog reading to psi
   
  // Serial.print("Druk: ");
  // Serial.print(pressureValue, 1); //prints value from previous line to serial
  // Serial.print(" psi; raw: "); //prints label to serial
  Serial.println(analogRead(pressureInput));
  delay(sensorreadDelay); //delay in milliseconds between read values
}
