JayDHulster/ithappens/(commit log)

2023-03-24 pcb files
    [biosensor.kicad_pcb, biosensor.kicad_sch]
2023-06-01 before esp change
    [biosensor.kicad_sch]
2023-06-04 massive update to pcb
    [biosensor.kicad_sch]
2023-06-07 final update?
    [biosensor-B_Cu.gbr, biosensor-B_Mask.gbr, biosensor-B_Paste.gbr, biosensor-B_Silkscreen.gbr, biosensor-Edge_Cuts.gbr, biosensor-F_Cu.gbr, biosensor-F_Mask.gbr, biosensor-F_Paste.gbr]
